ak66666/ThumbsUp-Trackball-v3/Photos/IMG_20250910_124810853.jpg

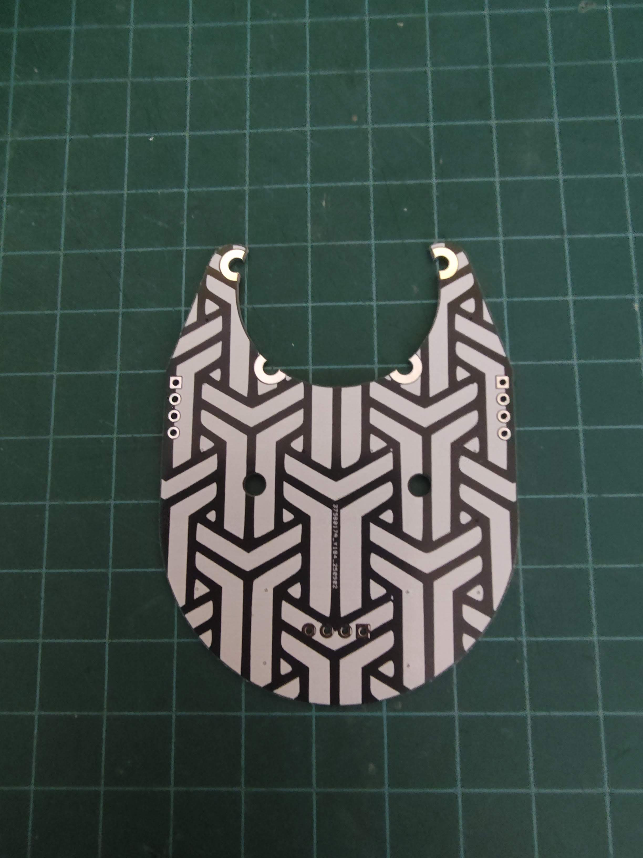
Photos/IMG_20250910_124810853.jpg
