ak66666/ThumbsUp-Trackball-v3/Photos/IMG_20250910_125017610.jpg

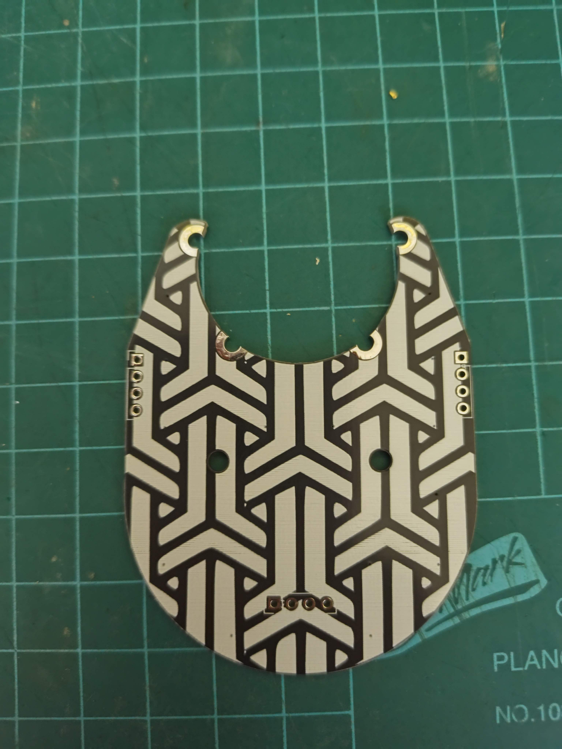
Photos/IMG_20250910_125017610.jpg
