ak66666/ThumbsUp-Trackball-v3/Photos/IMG_20250910_125026877.jpg

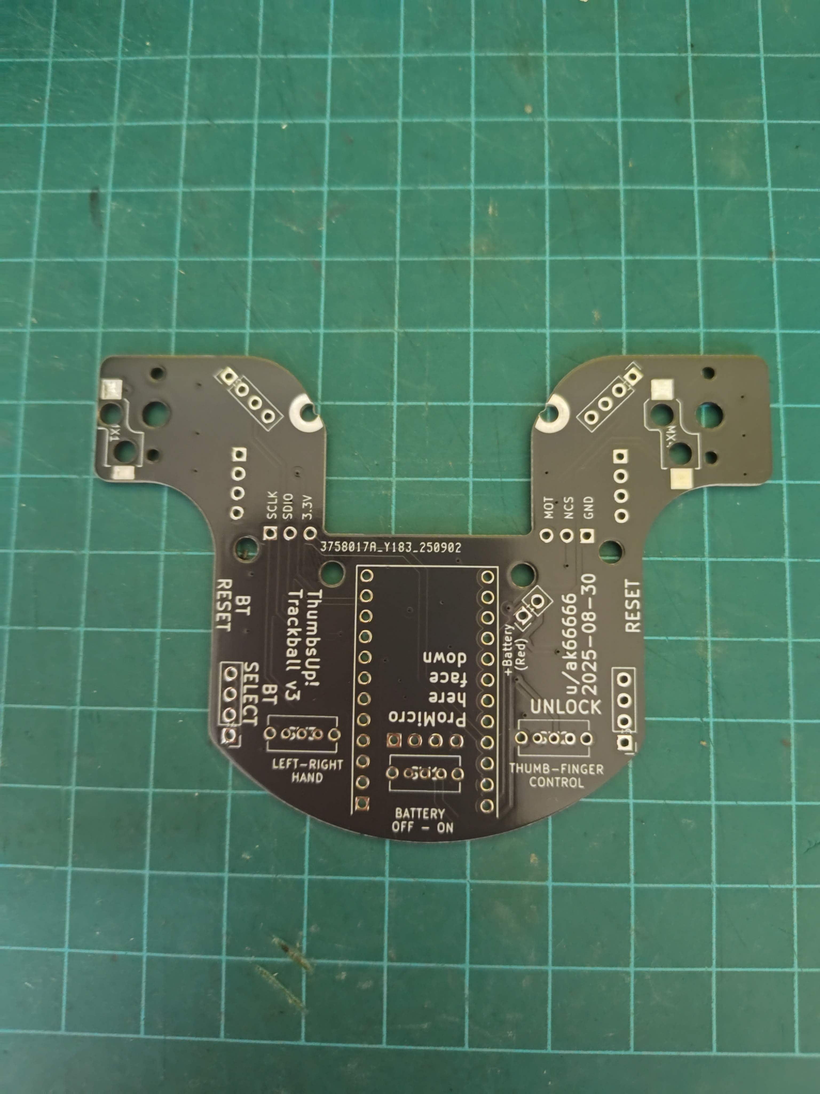
Photos/IMG_20250910_125026877.jpg
