ak66666/ThumbsUp-Trackball-v3/Photos/IMG_20250910_144632058_HDR.jpg

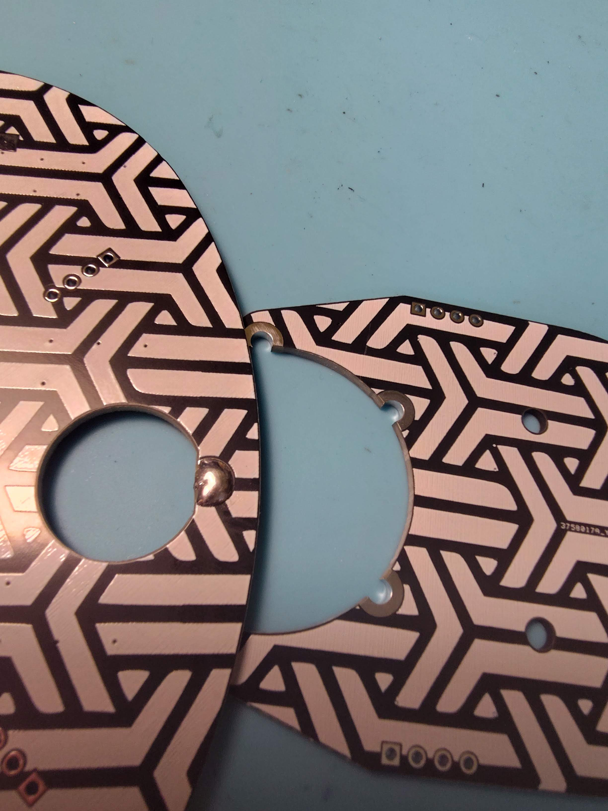
Photos/IMG_20250910_144632058_HDR.jpg
