ak66666/ThumbsUp-Trackball-v3/Photos/IMG_20250910_162734140.jpg

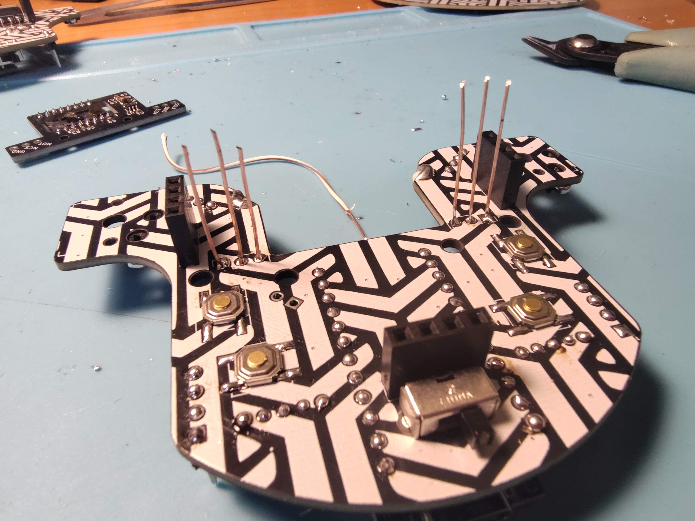
Photos/IMG_20250910_162734140.jpg
