ak66666/ThumbsUp-Trackball-v3/Photos/IMG_20250910_163006867.jpg

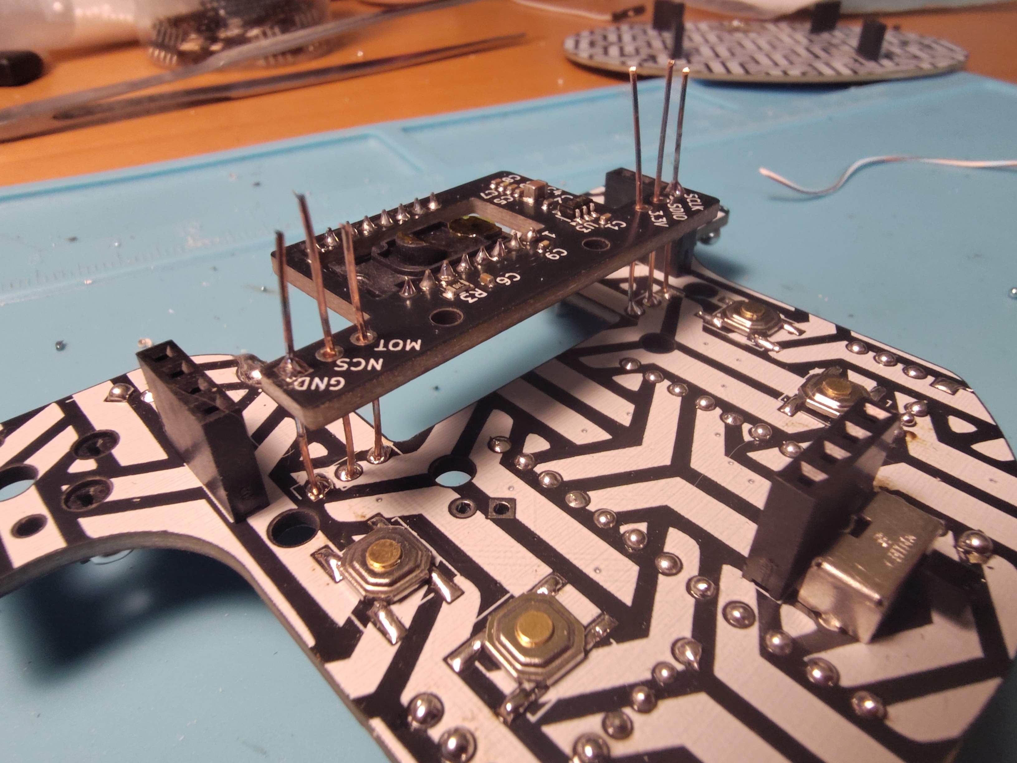
Photos/IMG_20250910_163006867.jpg
