ak66666/ThumbsUp-Trackball-v3/Photos/IMG_20250910_163232154.jpg

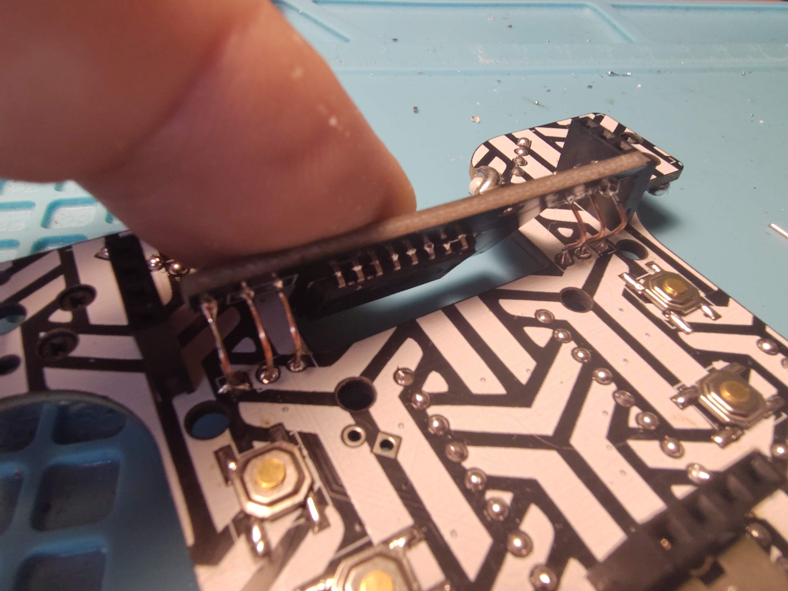
Photos/IMG_20250910_163232154.jpg
