ak66666/ThumbsUp-Trackball-v3/Photos/IMG_20250910_163306597_HDR.jpg

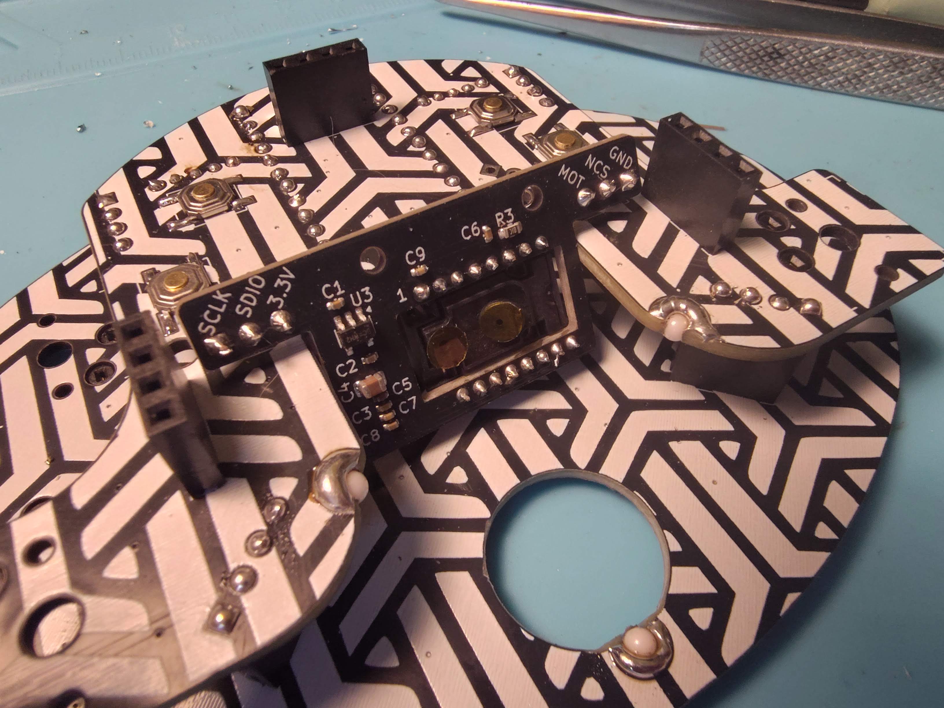
Photos/IMG_20250910_163306597_HDR.jpg
