ak66666/ThumbsUp-Trackball-v3/Photos/IMG_20250910_185215428.jpg

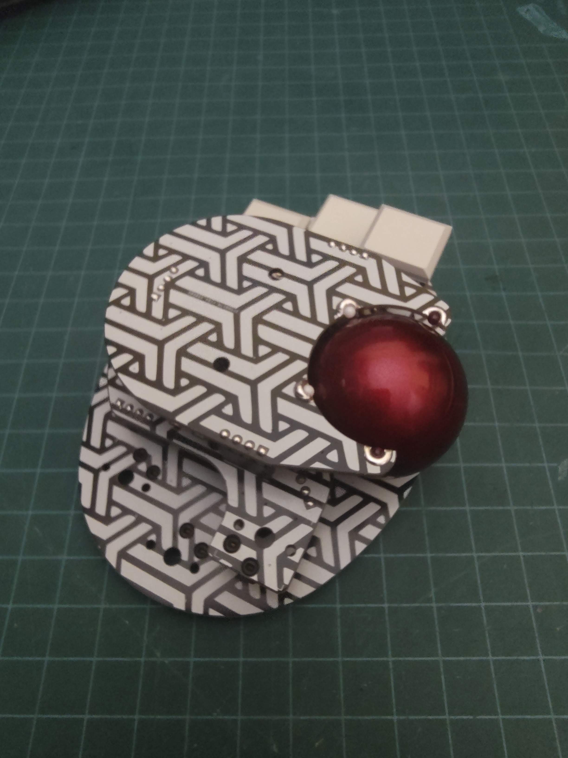
Photos/IMG_20250910_185215428.jpg
