ak66666/ThumbsUp-Trackball-v3/Photos/IMG_20250910_185756508~2.jpg

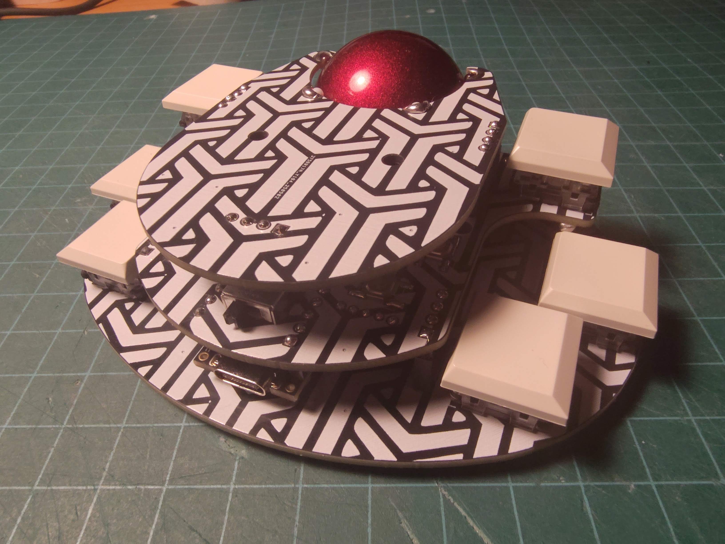
Photos/IMG_20250910_185756508~2.jpg
