ak66666/ThumbsUp-Trackball-v3/Photos/IMG_20250910_202240941~2.jpg

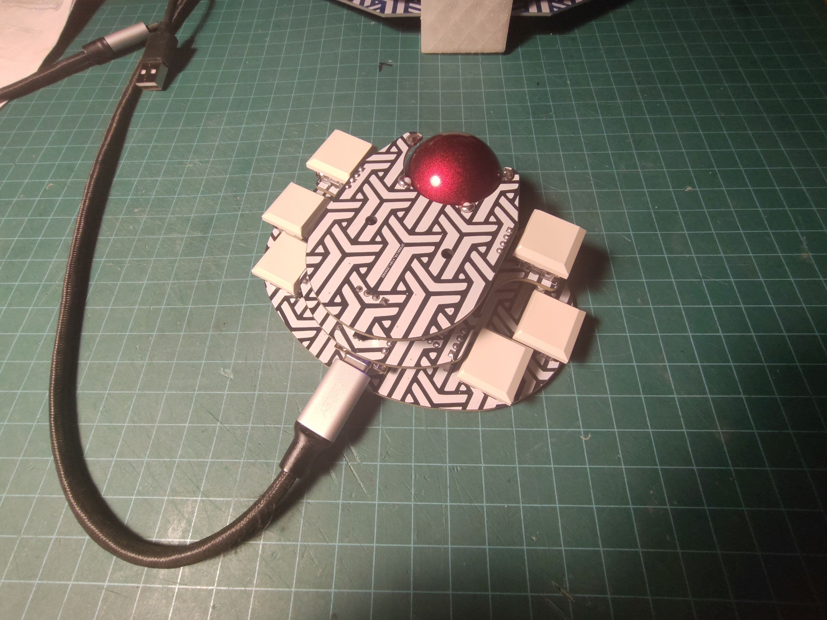
Photos/IMG_20250910_202240941~2.jpg
