ak66666/ThumbsUp-Trackball-v3/Photos/IMG_20250911_090125606.jpg

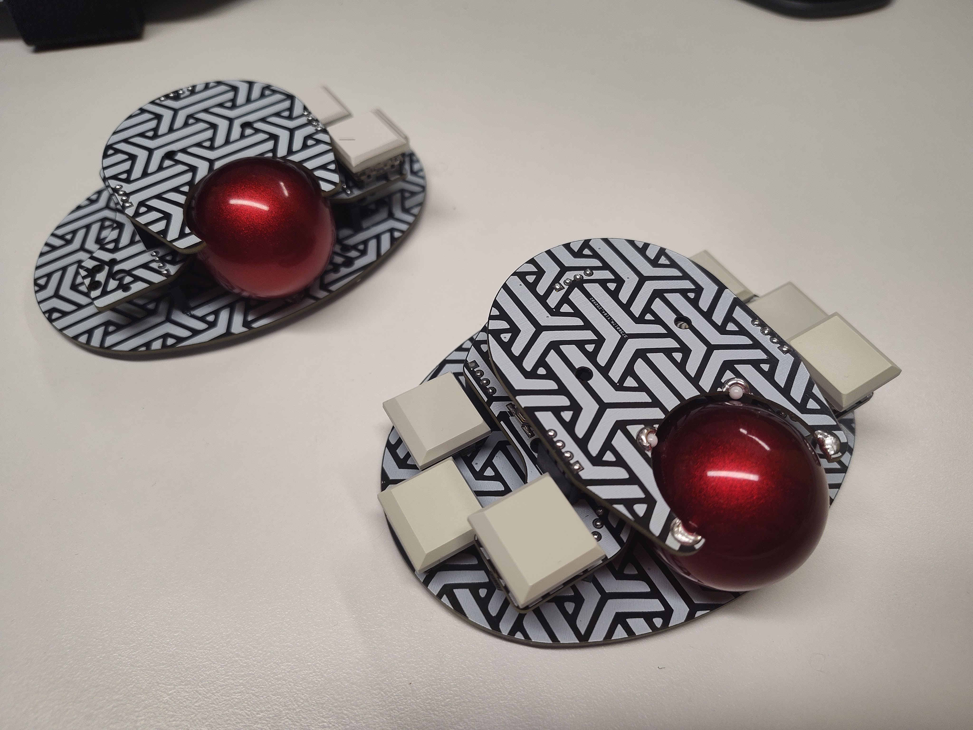
Photos/IMG_20250911_090125606.jpg
