ak66666/ThumbsUp-Trackball-v3/Photos/IMG_20250911_090554879.jpg

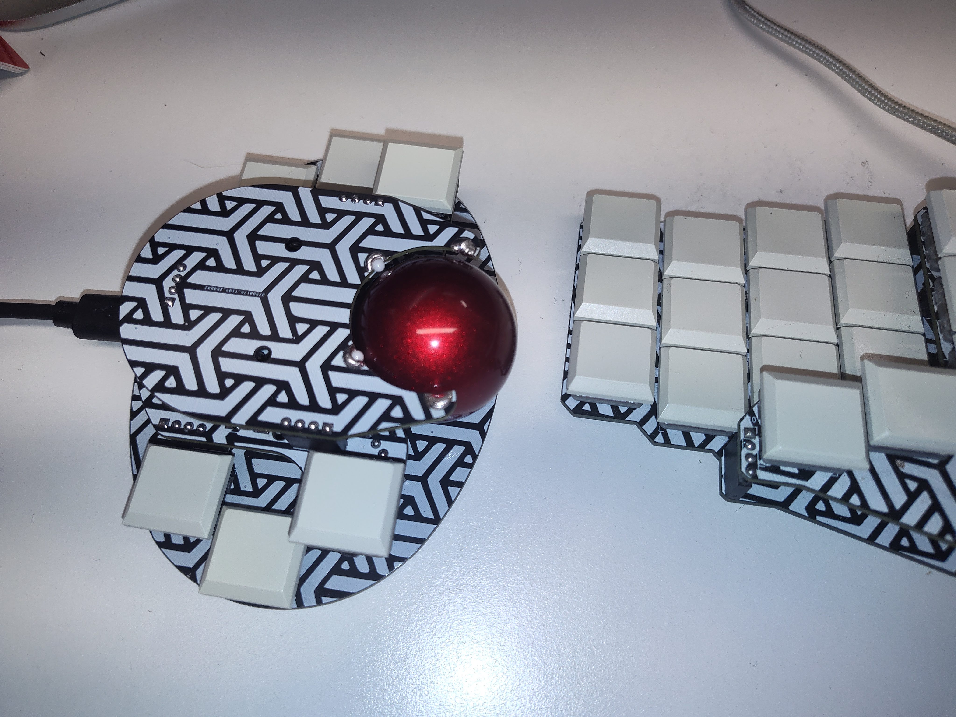
Photos/IMG_20250911_090554879.jpg
