ak66666/ThumbsUp-Trackball-v3/Photos/IMG_20250911_090740911_HDR.jpg

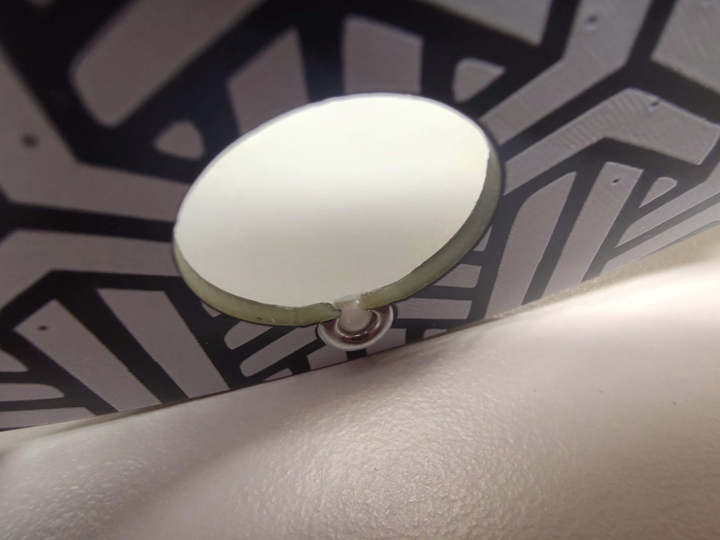
Photos/IMG_20250911_090740911_HDR.jpg
