ak66666/ThumbsUp-Trackball-v3/Photos/IMG_20250911_090751981.jpg

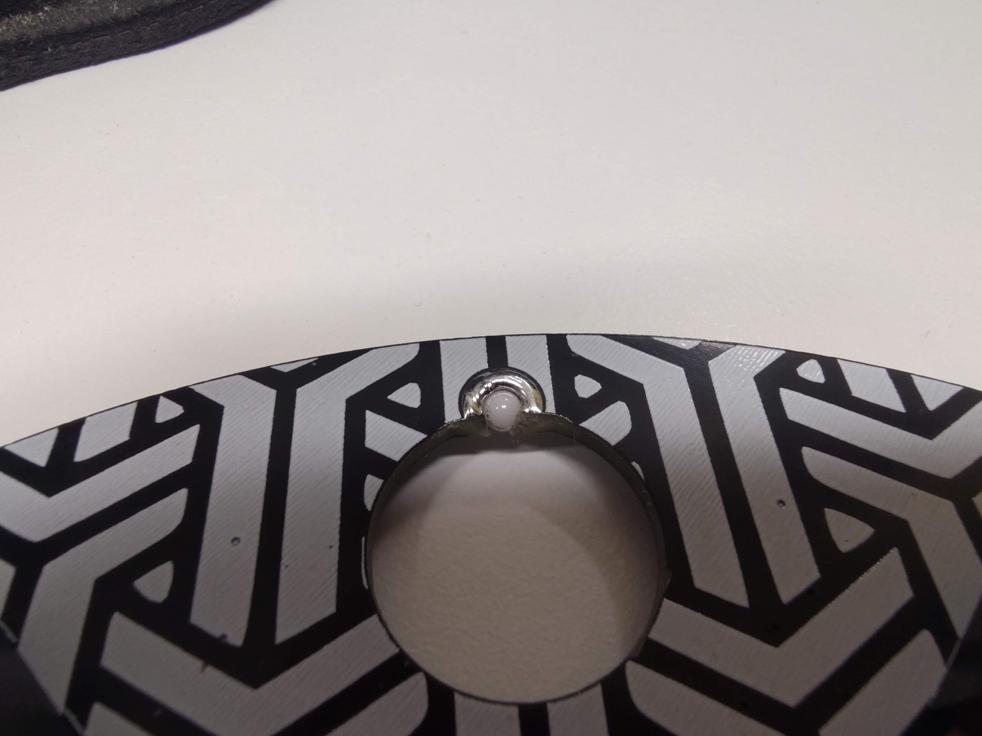
Photos/IMG_20250911_090751981.jpg
