ak66666/ThumbsUp-Trackball-v3/Kicad/Trackball/Fabrication/Parts, Costs.xlsx

# | Part | Quantity | Price, CAD | Cost, CAD | Source
1 | PMW3610 sensor and lens | 1 | 5.99 | 5.99 | https://www.aliexpress.com/item/1005007118767775.html
2 | Nice!nano v2 (or clone) | 1 | 6.70 | 6.70 | https://www.aliexpress.com/item/1005006074191337.html
3 | 34mm ball | 1 | 19.08 | 19.08 | https://www.aliexpress.com/item/1005007857787050.html
4 | 3.7V 110mAh 301230 Lithium Polymer Li-Po Battery | 1 | 2.24 | 2.24 | https://www.aliexpress.com/item/1005003662352305.html
5 | Kailh Choc hot-swap sockets | 6 | 0.19 | 1.14 | https://www.aliexpress.com/item/1005003873653184.html
6 | Kailh Choc White Clicky swithces | 6 | 1.00 | 6.00
7 | Kailh Choc Key Cap | 6 | 1.00 | 6.00
8 | 12 Pin Headers Low profile, for Nice!nano. | 2 | 0.09 | 0.19 | https://www.aliexpress.com/item/1005007217493310.html
9 | 12 Pin Sockets, Low profile, for Nice!nano. | 2 | 0.42 | 0.85 | https://www.aliexpress.com/item/1005006248653180.html
10 | 4pin Sockets and pin headers for them for the board stands. | 7 | 0.02 | 0.16 | https://www.aliexpress.com/item/1005005258694395.html
11 | 4pin Sockets and pin headers for them for the board stands. | 7 | 0.11 | 0.77 | https://www.aliexpress.com/item/1005003610333849.html
12 | 2.5mm ZrO2 Ceramic Balls | 7 | 0.51 | 3.58 | https://www.aliexpress.com/item/1005008831542121.html
13 | Slide Switches (Power, Orientation, Handiness) | 3 | 0.49 | 1.48 | https://www.mouser.ca/ProductDetail/655-1825232-1
14 | 5x5mm Tactile Switches | 4 | 0.51 | 2.05 | https://www.mouser.ca/ProductDetail/611-PTS525SKG15JSMTR
15 | 6x 8x3mm Bumpons | 6 | 0.04 | 0.26 | https://www.aliexpress.com/item/1005005287385986.html
16 | Stand-offs w/nuts | 4 | 0.10 | 0.39 | https://www.amazon.ca/dp/B0BR5MT7R1
17 | 0.5 washers | 4 | 0.09 | 0.38 | https://www.amazon.ca/dp/B0F29B674L
18 | M3 screws | 4 | 0.10 | 0.42 | https://www.amazon.ca/dp/B07C72FBZ6
19 | PCB set | 1 | 60.00 | 60.00 | Price as sold at Etsy, less if ordered 20 sets from JLCPCB by yourself
 | Total without PCBs |  | 38.70
 | Total |  | 98.70
