ak66666/ThumbsUp-Trackball-v3/Kicad/Trackball/Fabrication/Sensor Module BOM, as ordered 20250820.xls

Comment | Designator | Footprint | JLCPCB Part #
1m | C2 | C_0402_1005Metric | C14445
3.3uF/16V | C4 | C_0805_2012Metric | C15850
10k | R3 | R_0603_1608Metric | C25804
0.1u | C3,C1,C5,C6,C8 | C_0402_1005Metric | C1525
TCR2EF19 | U3 | SOT-23-5 | C27416
0.01u | C7,C9 | C_0402_1005Metric | C15195
