ak66666/ThumbsUp-Trackball-v3/Dongle Case/Dongle Case.stl

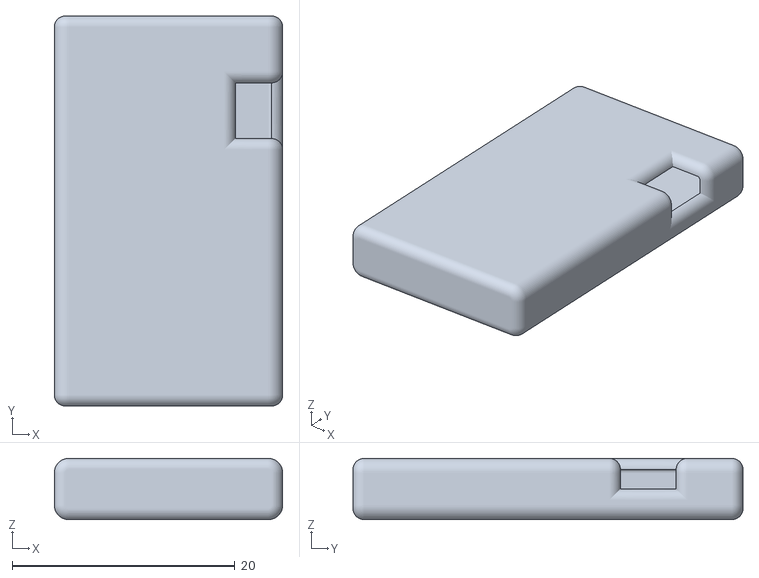
[picture p54: CAD file, 2025-09-03]
Dongle Case/Dongle Case.stl
20.5 x 35.0 x 5.50
