ak66666/ThumbsUp-Trackball-v3/Kicad/Trackball/Pictures/PCBs.3mf

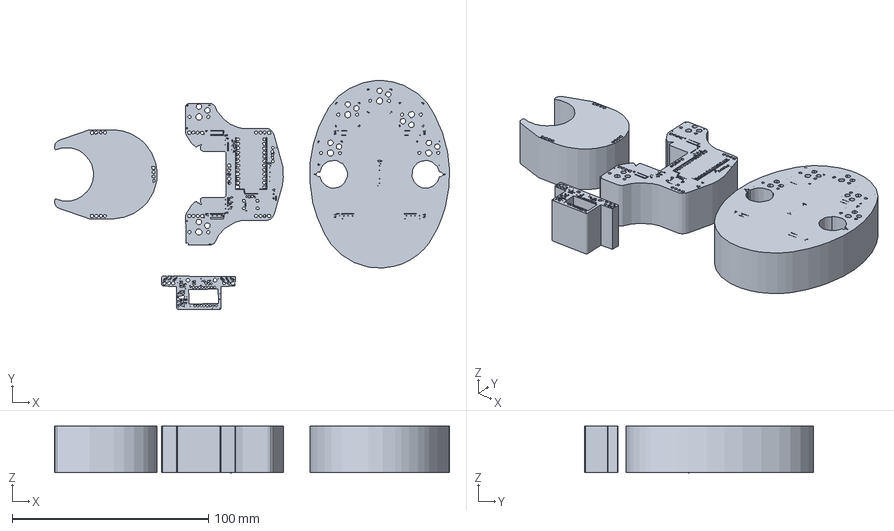
[picture p55: CAD file, 2025-08-20]
Kicad/Trackball/Pictures/PCBs.3mf
201.2 x 116.6 x 23.8 mm
