ak66666/ThumbsUp-Trackball-v3/(list of files, cad)

Other CAD files:
Kicad/Trackball/1825232-1/Allegro/18252321.psm
Kicad/Trackball/1825232-1/DEHDL/1825232_1/chips/chips.prt
