ak66666/ThumbsUp-Trackball-v3/Photos/Assembly Process/IMG_20250912_110830586_HDR.jpg

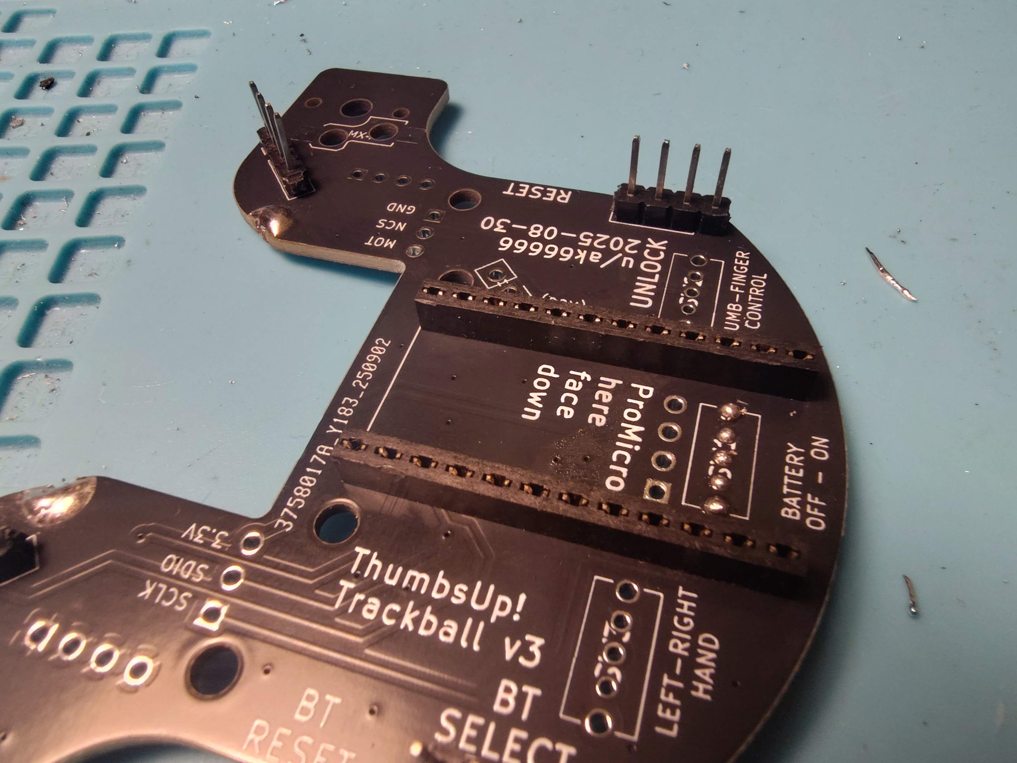
Photos/Assembly Process/IMG_20250912_110830586_HDR.jpg
