ak66666/ThumbsUp-Trackball-v3/Photos/Assembly Process/IMG_20250912_113734502_HDR.jpg

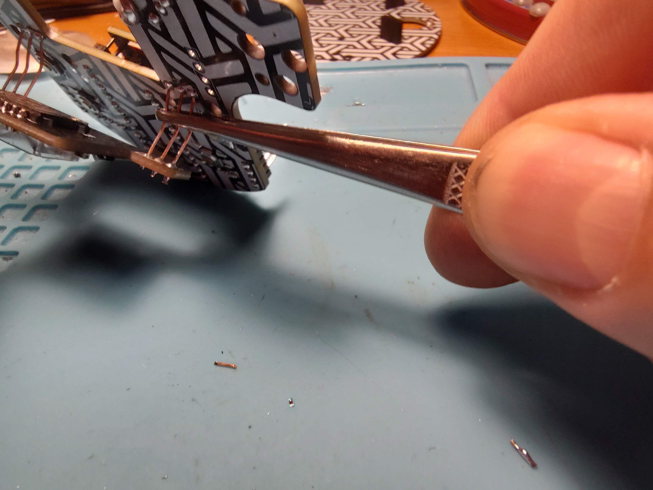
Photos/Assembly Process/IMG_20250912_113734502_HDR.jpg
