ak66666/ThumbsUp-Trackball-v3/Photos/Assembly Process/IMG_20250912_113752580_HDR.jpg

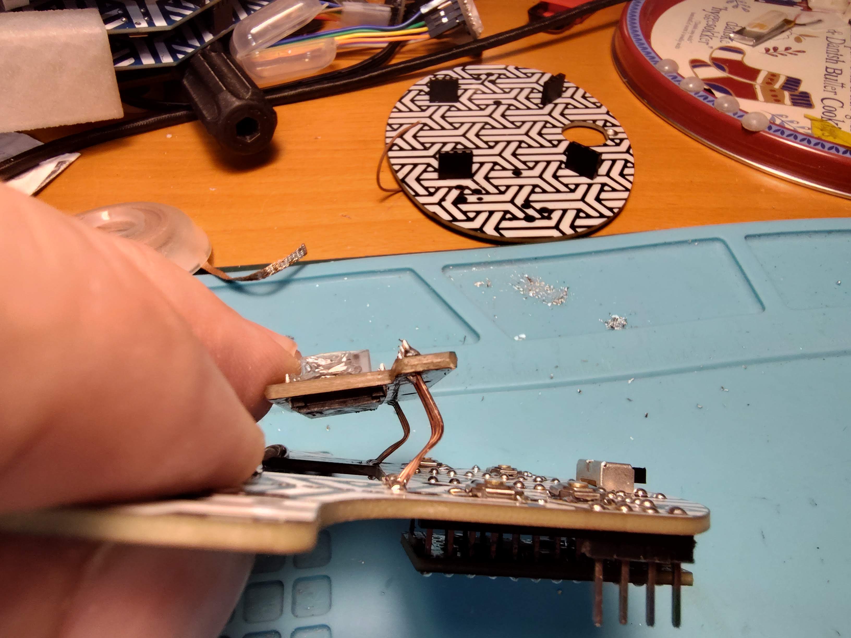
Photos/Assembly Process/IMG_20250912_113752580_HDR.jpg
