ak66666/ThumbsUp-Trackball-v3/Photos/Assembly Process/IMG_20250912_113833317.jpg

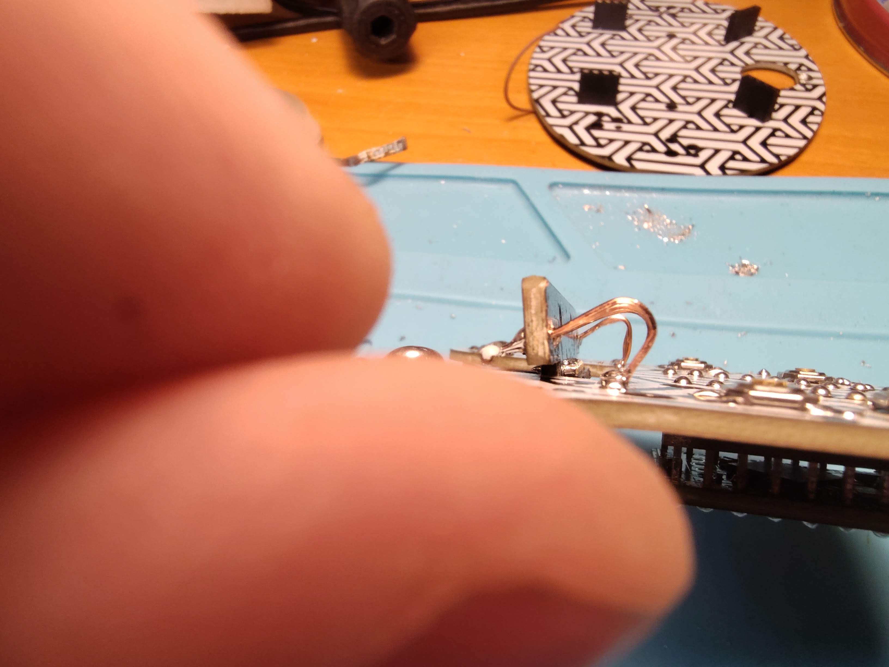
Photos/Assembly Process/IMG_20250912_113833317.jpg
