ak66666/ThumbsUp-Trackball-v3/Photos/Assembly Process/IMG_20250912_120129462_HDR.jpg

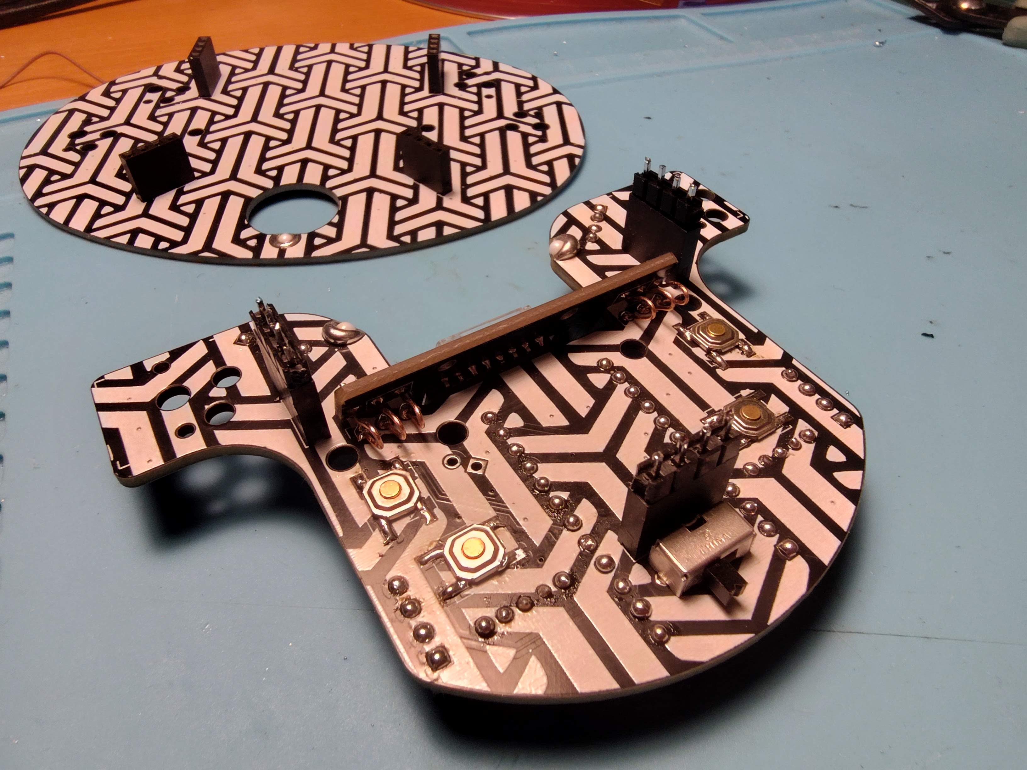
Photos/Assembly Process/IMG_20250912_120129462_HDR.jpg
