ak66666/ThumbsUp-Trackball-v3/Photos/Assembly Process/IMG_20250912_120154208_MP.jpg

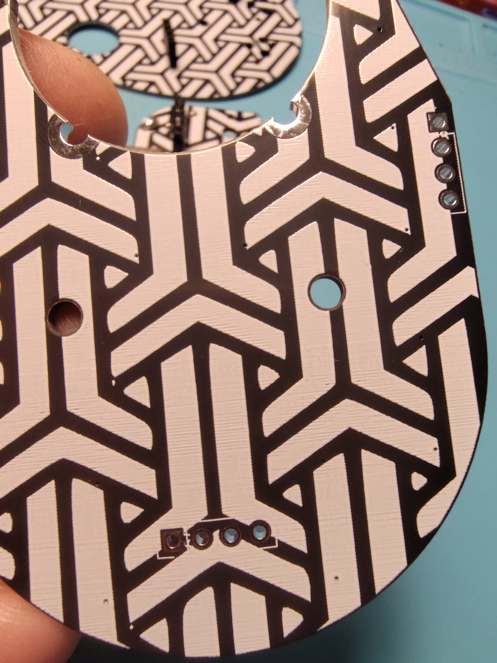
Photos/Assembly Process/IMG_20250912_120154208_MP.jpg
