ak66666/ThumbsUp-Trackball-v3/Photos/Assembly Process/IMG_20250912_122436051_HDR.jpg

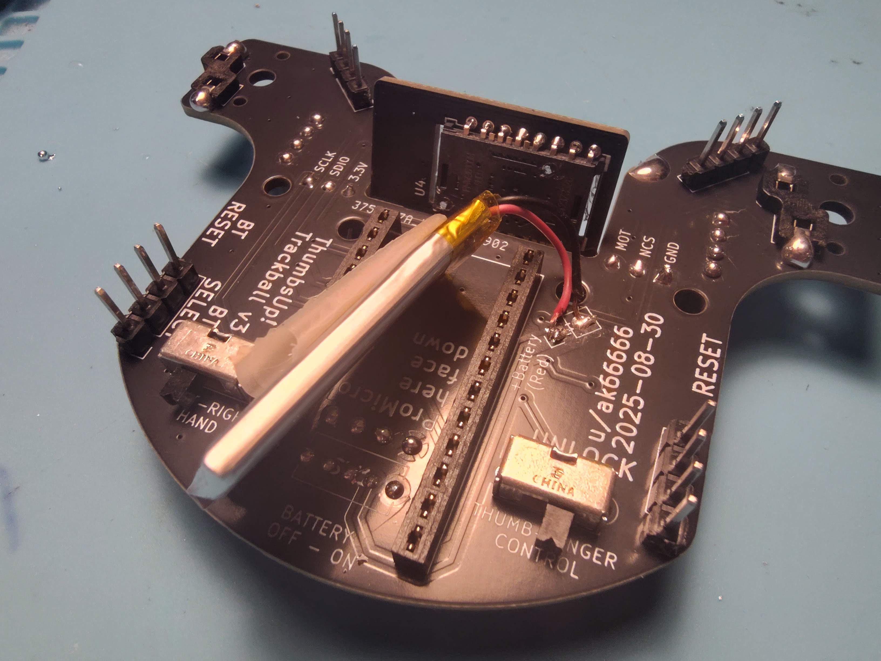
Photos/Assembly Process/IMG_20250912_122436051_HDR.jpg
