ak66666/ThumbsUp-Trackball-v3/Photos/Assembly Process/IMG_20250912_123638251.jpg

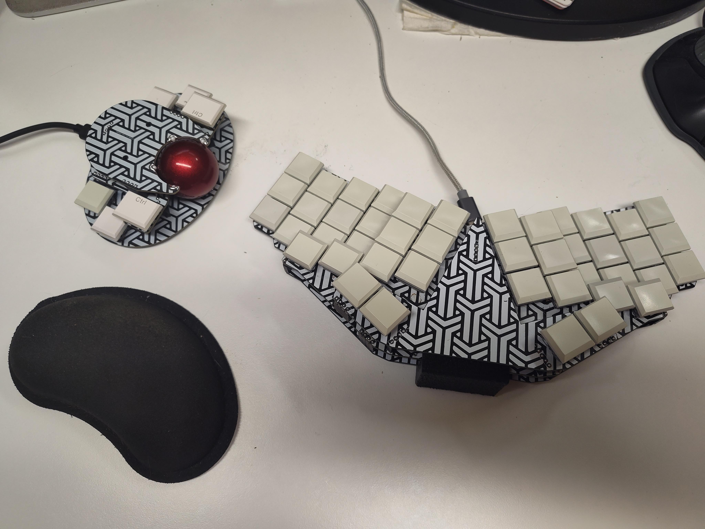
Photos/Assembly Process/IMG_20250912_123638251.jpg
