ak66666/ThumbsUp-Trackball-v3/(list of files, drawings)

Other design files:
Kicad/Trackball/1825232-1/Altium/1825232-1.SchLib
Kicad/Trackball/1825232-1/Altium/18252321.PcbLib
