ak66666/ThumbsUp-Trackball-v3/(commit log)

2025-07-30 Trackball v2 cloned from the initial project.
    [52559-1233.stp, 525591233.psm, EDI2CAP.CFG, Trackball.kicad_pcb, Trackball.sch, chips.prt]
2025-08-01 Trackball v2: Initial project draft, lot of changes coming.
    [52559-1233.stp, 525591233.psm, EDI2CAP.CFG, Trackball.kicad_sch, Trackball.sch, chips.prt]
2025-08-10 Trackball v2: Added more buttons, the optical sensor components. The schematics seems to be complete - yet there could be changes driven by the PCB design
    [1825232-1.SchLib, 1825232-1.stp, 18252321.PcbLib, 18252321.psm, EDI2CAP.CFG, Trackball.kicad_pcb, Trackball.kicad_sch, chips.prt]
2025-08-11 Trackball v2: Made the PCB outlines, except for the sensor and its connecting lip.
    [Trackball.kicad_pcb, Trackball.kicad_sch]
2025-08-16 Trackball v2: Laid out the sensor board. Todo: its connection to the middle PCB. & git push
    [Trackball.kicad_pcb, Trackball.kicad_sch]
2025-08-19 Trackball v2: Re-laid out the sensor board. Todo: its connection to the middle PCB. & git push
    [Trackball.kicad_pcb]
2025-08-19 Trackball v2: Re-laid out the sensor board once again. Todo: its connection to the middle PCB. & git push
    [Trackball.kicad_pcb, Trackball.kicad_sch]
2025-08-19 Trackball v2: Udpated middle PCB's outline to match the sensor board. Todo: its connection to the middle PCB. & git push
    [Trackball.kicad_pcb, Trackball.kicad_sch]
2025-08-20 Trackball v2: Added BT Reset button, put the bearing holding caps. Todo: its connection to the middle PCB. & git push
    [PCBs.3mf, Trackball.kicad_pcb, Trackball.kicad_sch]
2025-08-20 Trackball v2: Laid out all tracks. To do: add the screensilk and verify everything..
    [Trackball.kicad_pcb, Trackball.kicad_sch]
2025-08-21 Trackball v2: Covered the large holes with break-out panels, added silkscreens. To do: verify and produce Gerbers..
    [Trackball.kicad_pcb]
2025-08-21 Trackball v2: Added Gerbers, other fabrication files..
    [BOM as ordered 20250820.xls, L2-BOM.xlsx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]
2025-08-30 A-Ball v3: Changed schematics, outlines. To do: traces
    [Trackball.kicad_pcb, Trackball.kicad_sch]
2025-08-30 A-Ball v3: Layed out the schematics. To do: generate Gerbers.
    [Trackball.kicad_pcb, Trackball.kicad_sch]
2025-08-31 A-Ball v3: Tweaked out the layout, added more bearing holders, etc. To do: generate Gerbers.
    [Trackball.kicad_pcb, Trackball.kicad_sch]
2025-09-01 A-Ball v3: Added BT Control, Studio Unlock keys.
    [Trackball.kicad_pcb, Trackball.kicad_sch]
2025-09-03 A-Ball: ZMK: Added a (re-designed) sleeve case for the dongle..
    [Dongle Case.stl]
2025-09-10 A-Ball v3: Started working on the firmware, for now Bluetooth/wired version.
2025-09-10 A-Ball v3: moved zmk firmware into https://github.com/ak66666/zmk-config-trackball.v3
    [Trackball-B_Cu.gbr, Trackball-B_Mask.gbr, Trackball-B_Paste.gbr, Trackball-B_Silkscreen.gbr, Trackball-Edge_Cuts.gbr, Trackball-F_Cu.gbr, Trackball-F_Mask.gbr, Trackball-F_Paste.gbr]
2025-09-10 A-Ball v3: Downloaded BOM as it was ordered the last time.
    [BOM, as ordered 20250820.xls]
2025-09-12 A-Ball v3: Added photos from the assembly instructions page.
2025-09-19 B3: Rev.1 is ready. TODO: Re-create Gerbers.
    [Trackball.kicad_pcb]
2025-09-19 B3: Added button labels on the back side of the top deck. TODO: Prepare Gerbers for fabrication.
    [Trackball.kicad_pcb]
2025-09-19 B3: Gerbers prepared.
    [Sensor Module BOM, as ordered 20250820.xls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]
2025-09-19 B3: Gerbers for L1 Bottom re-done: rotated 45 degrees to fit into 100x100mm limit..
    [Trackball-B_Cu.gbr, Trackball-B_Mask.gbr, Trackball-B_Paste.gbr, Trackball-B_Silkscreen.gbr, Trackball-Edge_Cuts.gbr, Trackball-F_Cu.gbr, Trackball-F_Mask.gbr, Trackball-F_Paste.gbr]
2025-09-23 B3: Added BOM for parts.
    [Parts, Costs.xlsx]
2025-09-24 B3: Replaced cross-board link holes with padded holes.
    [Trackball.kicad_pcb, Trackball.kicad_sch]
2025-09-24 B3: Moved the switch and button labels around.
    [Trackball.kicad_pcb]
2025-09-24 B3: Added labels on top of the silkscreen, added instructions how to generate the files to get them displayed correctly.
    [Trackball.kicad_pcb]
2025-10-01 B3: Re-generated Gerbers for re-fabrication 20251001.
    [Trackball-B_Cu.gbr, Trackball-B_Mask.gbr, Trackball-B_Paste.gbr, Trackball-B_Silkscreen.gbr, Trackball-Edge_Cuts.gbr, Trackball-F_Cu.gbr, Trackball-F_Mask.gbr, Trackball-F_Paste.gbr]
